GadgetReboot/RS485_GPIO/README.md

# RS485_GPIO
16 Switch Inputs to RS485 Control Outputs
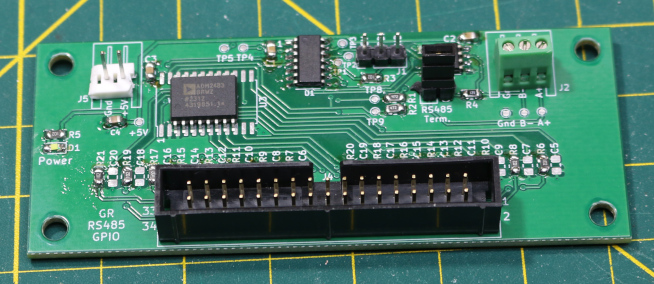
[picture p1: Assembled_PCB.JPG]
PCB
<br><br><BR><BR>
