GadgetReboot/RS485_GPIO/GR_RS485_Switches_Sch.pdf

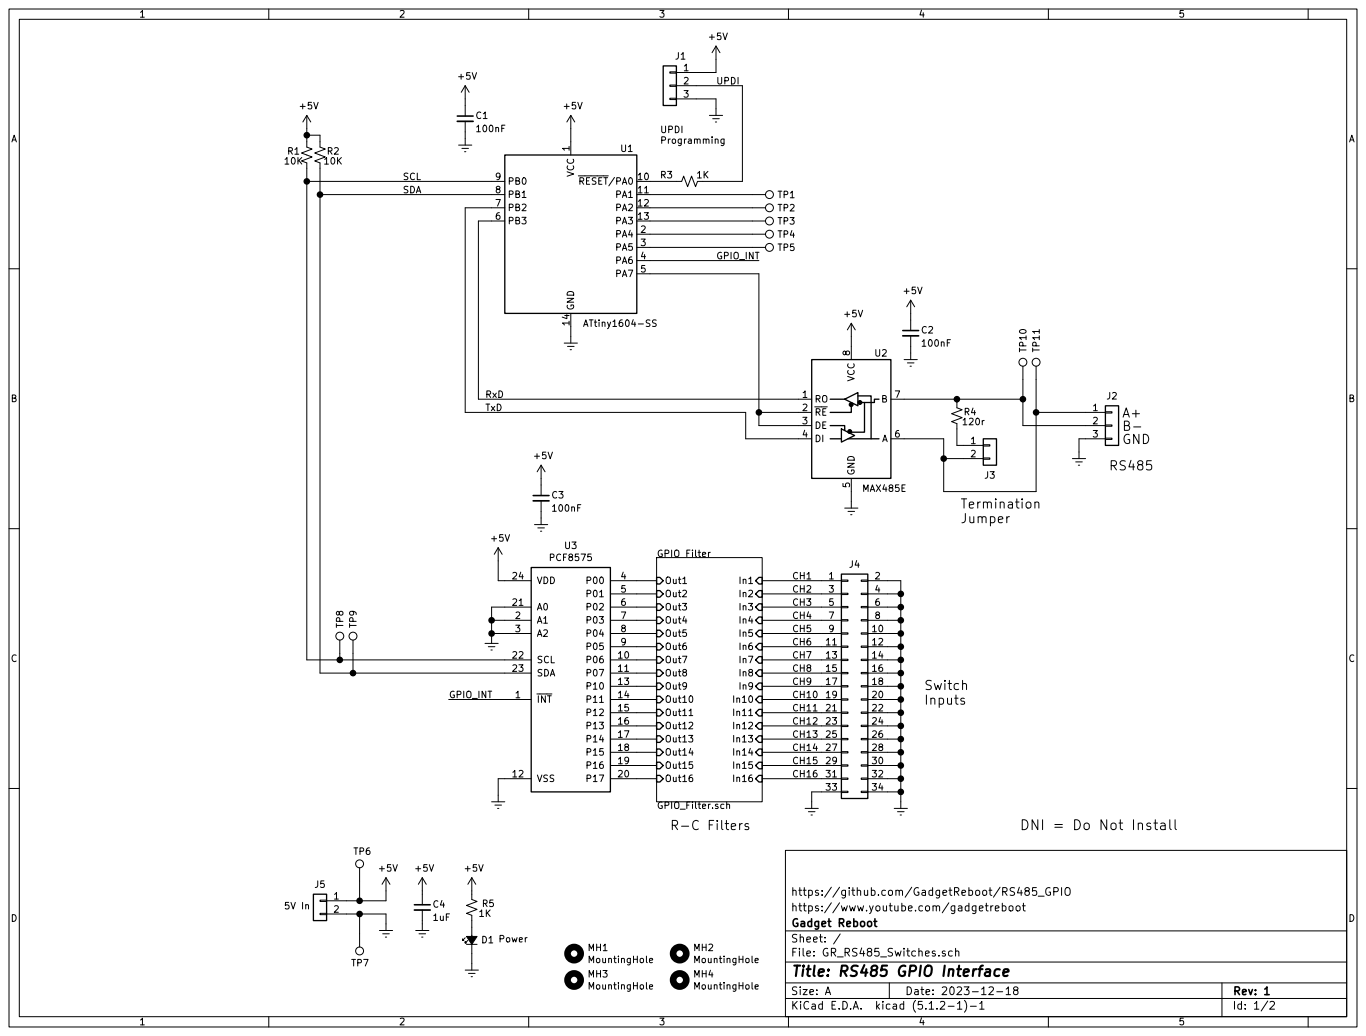
[picture p2: page 1]

15 | 16
17 | 18

21 | 22
23 | 24
25 | 26
27 | 28

https://github.com/GadgetReboot/RS485_GPIO
https://www.youtube.com/gadgetreboot
File: GR_RS485_Switches.sch Sheet: / Gadget Reboot

Id: 1/2 Title: RS485 GPIO Interface

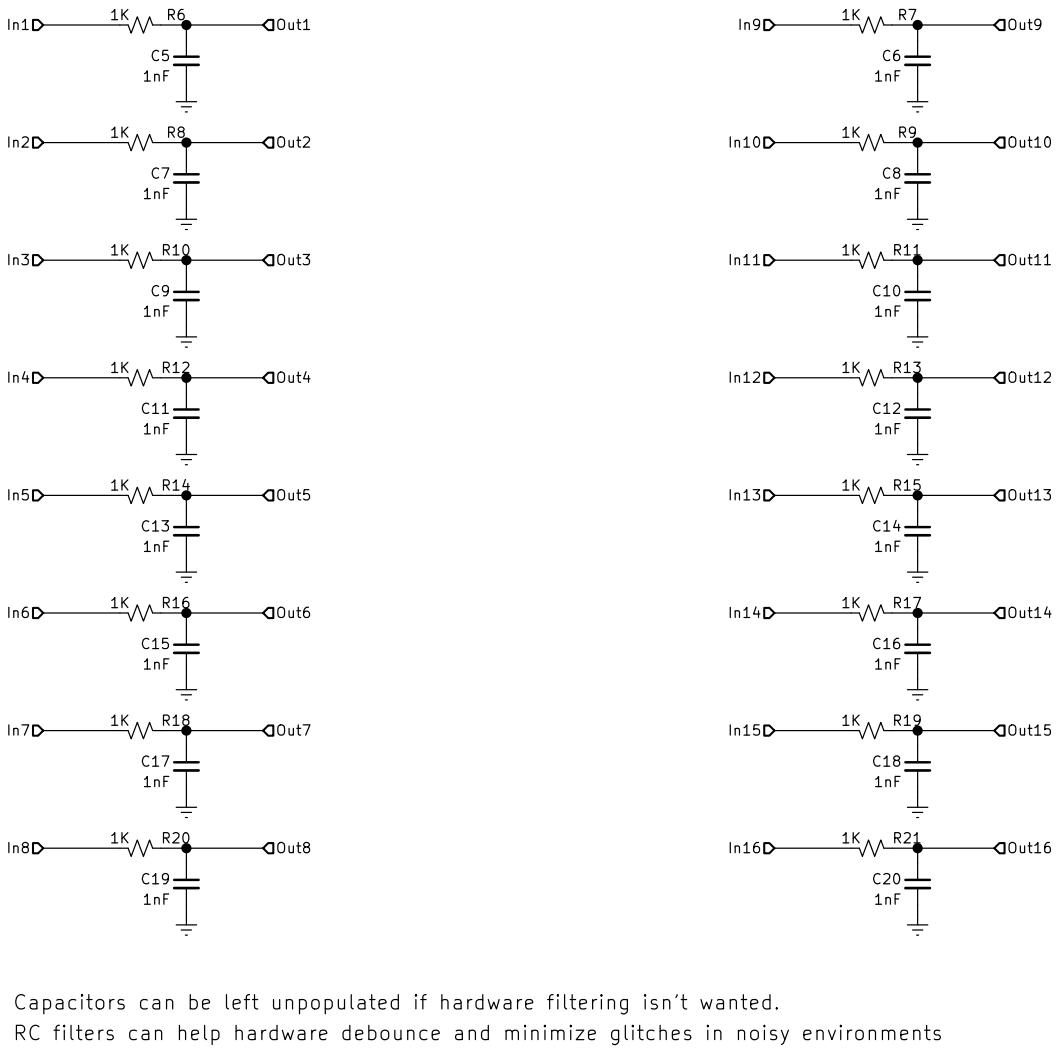
[picture p3: page 2]

Out9 Out10 Out11 Out12 Out13 Out14 Out15 Out16 Capacitors can be left unpopulated if hardware filtering isnt wanted.

RC filters can help hardware debounce and minimize glitches in noisy environments

File: GPIO_Filter.sch Sheet: /GPIO Filter/
Id: 2/2 Title:
