GadgetReboot/RS485_GPIO/KiCad/GR_RS485_Switches.kicad_pcb

## KiCad design KiCad/GR_RS485_Switches.kicad_pcb (2023-12-19)

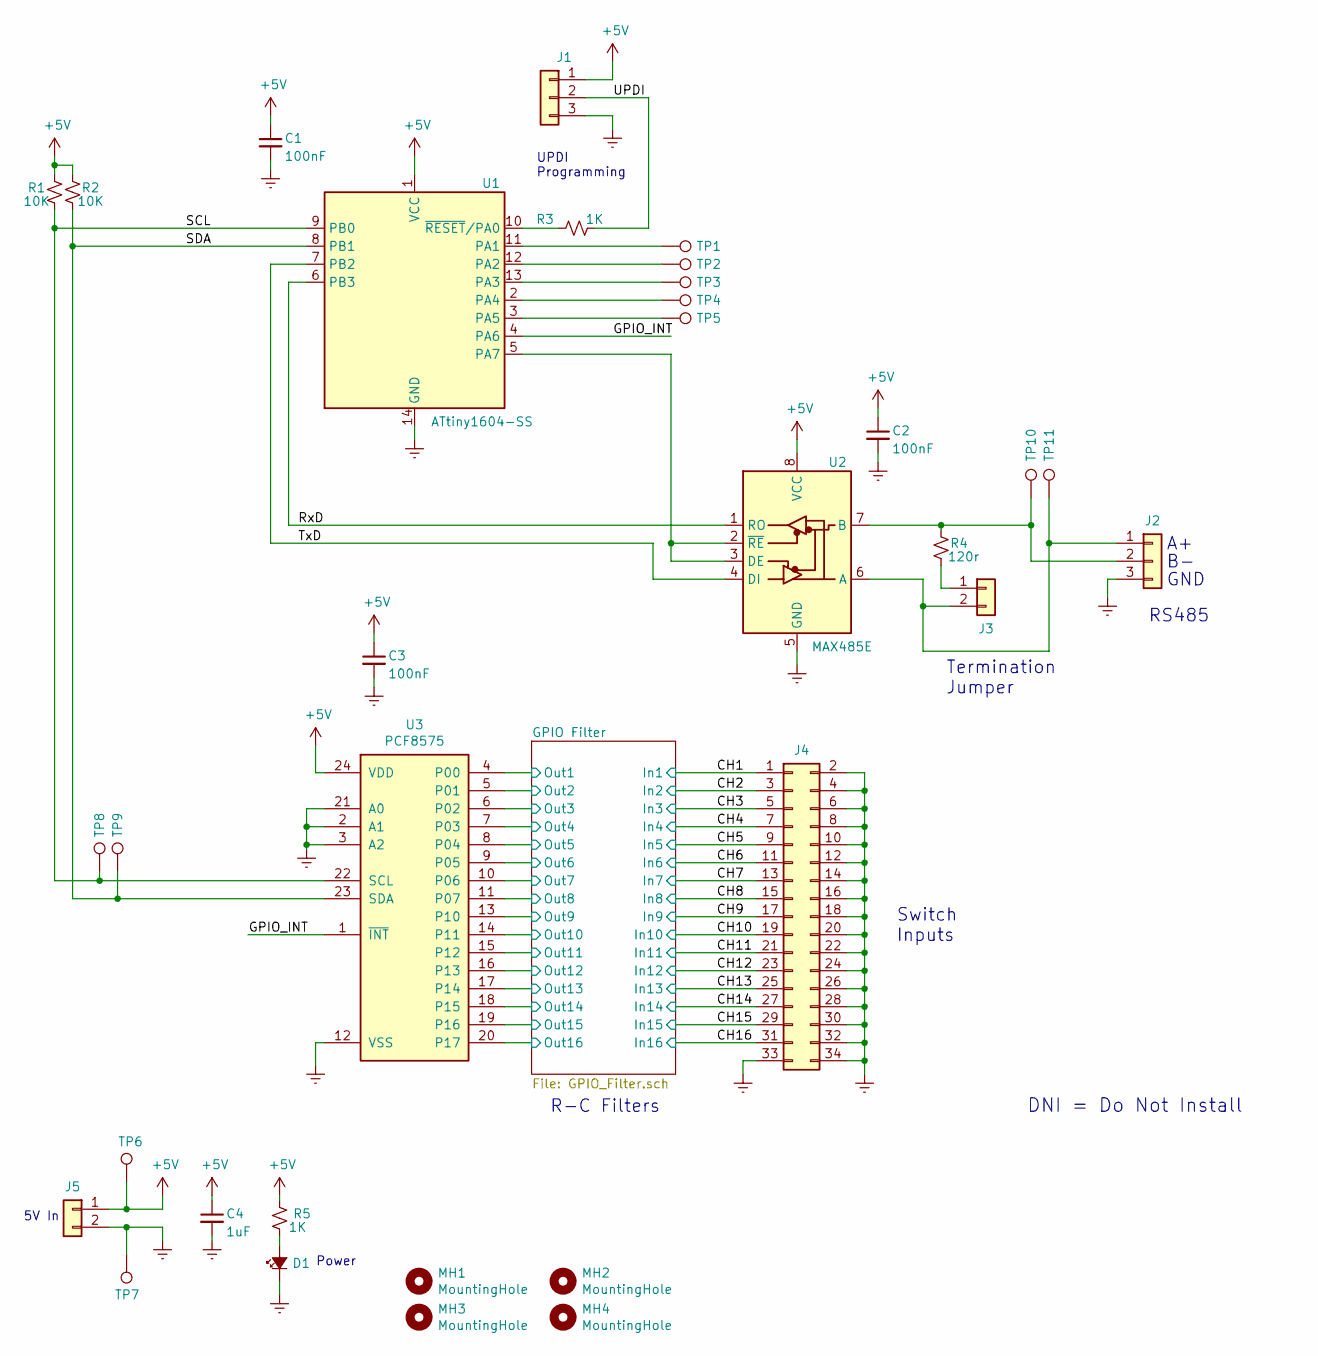
[picture p4: schematic GR_RS485_Switches.sch, RS485 GPIO Interface]

Parts:
C1, C2, C3: 100nF; C_0805_2012Metric_Pad1.15x1.40mm_HandSolder
C4: 1uF; C_0805_2012Metric_Pad1.15x1.40mm_HandSolder
D1: LED_Small_ALT; LED_0805_2012Metric_Pad1.15x1.40mm_HandSolder
J1: Conn_01x03; PinHeader_1x03_P2.54mm_Vertical
J2: Conn_01x03; JST_XH_S3B-XH-A-1_1x03_P2.50mm_Horizontal
J3: Conn_01x02; PinHeader_1x02_P2.54mm_Vertical
J4: Conn_02x17_Odd_Even; IDC-Header_2x17_P2.54mm_Vertical
J5: Conn_01x02; JST_XH_S2B-XH-A-1_1x02_P2.50mm_Horizontal
MH1, MH2, MH3, MH4: MountingHole; MountingHole_3.7mm
R1, R2: 10K; R_0805_2012Metric_Pad1.15x1.40mm_HandSolder
R3, R5: 1K; R_0805_2012Metric_Pad1.15x1.40mm_HandSolder
R4: 120r; R_0805_2012Metric_Pad1.15x1.40mm_HandSolder
TP1, TP2, TP3, TP4, TP5, TP6, TP7, TP8, TP9, TP10, TP11: TestPoint; TestPoint_Pad_D1.0mm
U1: ATtiny1604-SS; SOIC-14_3.9x8.7mm_P1.27mm
U2: MAX485E; SOIC-8_3.9x4.9mm_P1.27mm
U3: PCF8575; SOIC-24W_7.5x15.4mm_P1.27mm

Connections:
+5V: C1.1, C2.1, C3.1, C4.1, J1.1, J5.1, R1.2, R2.2, R5.2, TP6.1, U1.1 (VCC), U2.8 (VCC), U3.24 (VDD)
/CH1: J4.1; also elsewhere on the board
/CH2: J4.3; also elsewhere on the board
/CH3: J4.5; also elsewhere on the board
/CH4: J4.7; also elsewhere on the board
/CH5: J4.9; also elsewhere on the board
/CH6: J4.11; also elsewhere on the board
/CH7: J4.13; also elsewhere on the board
/CH8: J4.15; also elsewhere on the board
/CH9: J4.17; also elsewhere on the board
/CH10: J4.19; also elsewhere on the board
/CH11: J4.21; also elsewhere on the board
/CH12: J4.23; also elsewhere on the board
/CH13: J4.25; also elsewhere on the board
/CH14: J4.27; also elsewhere on the board
/CH15: J4.29; also elsewhere on the board
/CH16: J4.31; also elsewhere on the board
/GPIO Filter/Out1: U3.4 (P00); also elsewhere on the board
/GPIO Filter/Out2: U3.5 (P01); also elsewhere on the board
/GPIO Filter/Out3: U3.6 (P02); also elsewhere on the board
/GPIO Filter/Out4: U3.7 (P03); also elsewhere on the board
/GPIO Filter/Out5: U3.8 (P04); also elsewhere on the board
/GPIO Filter/Out6: U3.9 (P05); also elsewhere on the board
/GPIO Filter/Out7: U3.10 (P06); also elsewhere on the board
/GPIO Filter/Out8: U3.11 (P07); also elsewhere on the board
/GPIO Filter/Out9: U3.13 (P10); also elsewhere on the board
/GPIO Filter/Out10: U3.14 (P11); also elsewhere on the board
/GPIO Filter/Out11: U3.15 (P12); also elsewhere on the board
/GPIO Filter/Out12: U3.16 (P13); also elsewhere on the board
/GPIO Filter/Out13: U3.17 (P14); also elsewhere on the board
/GPIO Filter/Out14: U3.18 (P15); also elsewhere on the board
/GPIO Filter/Out15: U3.19 (P16); also elsewhere on the board
/GPIO Filter/Out16: U3.20 (P17); also elsewhere on the board
/GPIO_INT: U1.4 (PA6), U3.1 (~INT)
/RxD: U1.6 (PB3), U2.1 (RO)
/SCL: R1.1, TP8.1, U1.9 (PB0), U3.22 (SCL)
/SDA: R2.1, TP9.1, U1.8 (PB1), U3.23 (SDA)
/TxD: U1.7 (PB2), U2.4 (DI)
/UPDI: J1.2, R3.1
GNDREF: C1.2, C2.2, C3.2, C4.2, D1.1 (K), J1.3, J2.3, J4.2, J4.4, J4.6, J4.8, J4.10, J4.12, J4.14, J4.16, J4.18, J4.20, J4.22, J4.24, J4.26, J4.28, J4.30, J4.32, J4.33, J4.34, J5.2, TP7.1, U1.14 (GND), U2.5 (GND), U3.2 (A1), U3.3 (A2), U3.12 (VSS), U3.21 (A0); also elsewhere on the board
unnamed: D1.2 (A), R5.1
unnamed: J2.1, J3.2, TP11.1, U2.6 (A)
unnamed: J2.2, R4.2, TP10.1, U2.7 (B)
unnamed: J3.1, R4.1
unnamed: R3.2, U1.10 (~RESET~/PA0)
unnamed: TP1.1, U1.11 (PA1)
unnamed: TP2.1, U1.12 (PA2)
unnamed: TP3.1, U1.13 (PA3)
unnamed: TP4.1, U1.2 (PA4)
unnamed: TP5.1, U1.3 (PA5)
unnamed: U1.5 (PA7), U2.2 (~RE), U2.3 (DE)

Notes on the sheet:
5V In
UPDI Programming
DNI = Do Not Install
Switch Inputs
R-C Filters
GND
RS485
Termination Jumper
Power

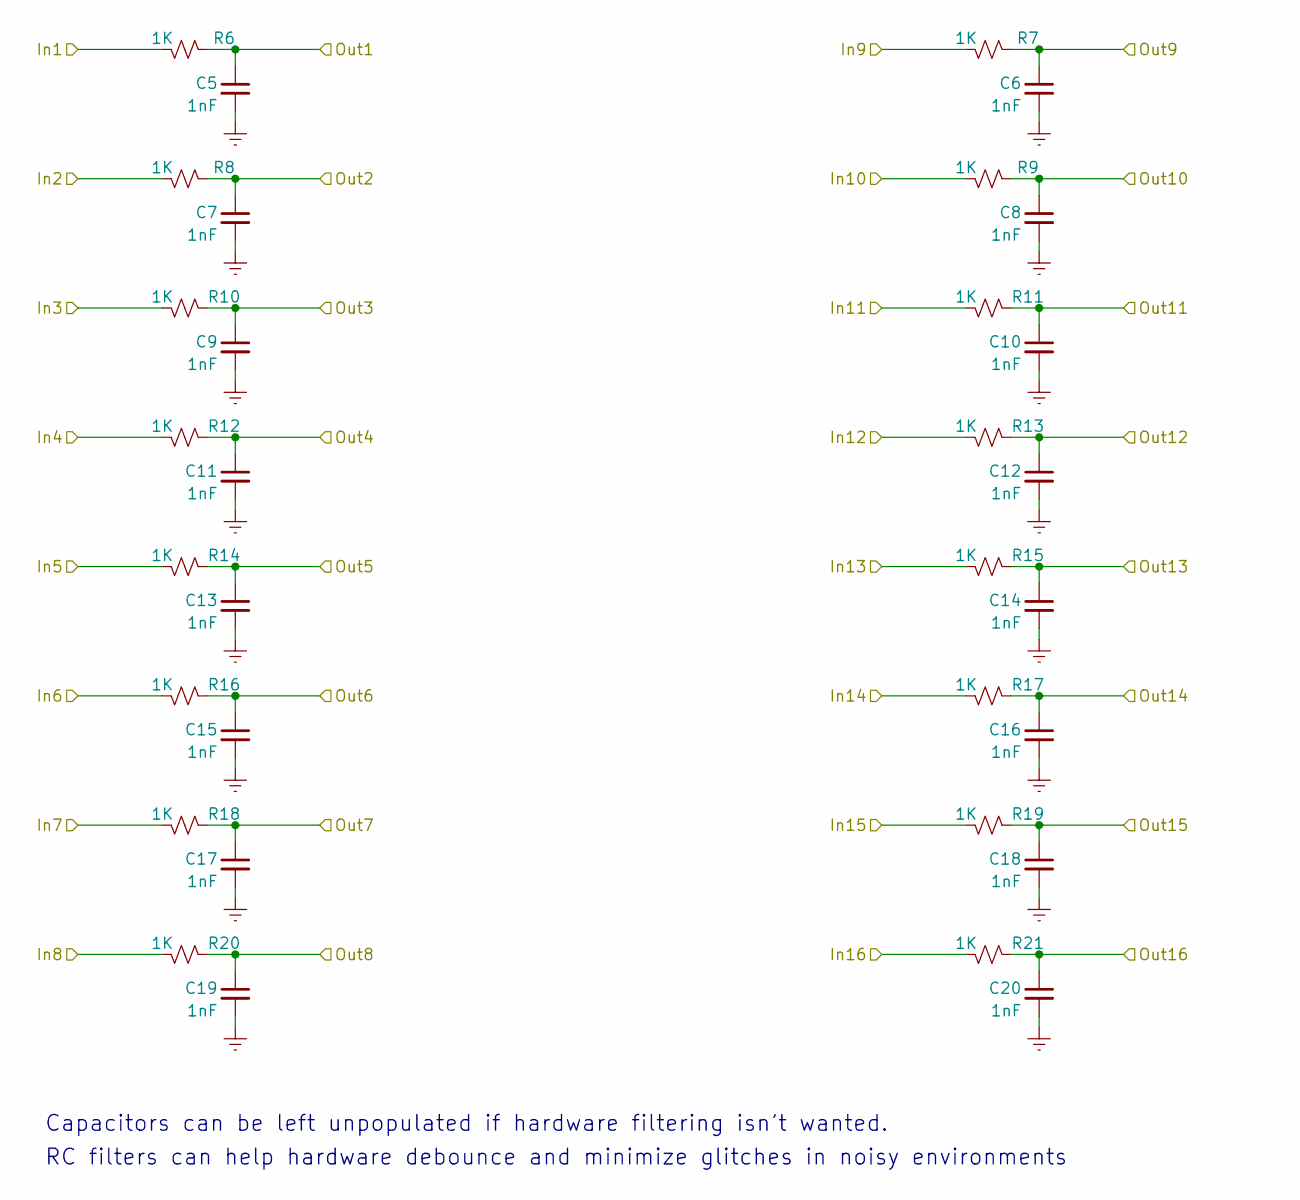
[picture p5: schematic GPIO_Filter.sch]

Parts:
C5, C6, C7, C8, C9, C10, C11, C12, C13, C14, C15, C16, C17, C18, C19, C20: 1nF; C_0805_2012Metric_Pad1.15x1.40mm_HandSolder
R6, R7, R8, R9, R10, R11, R12, R13, R14, R15, R16, R17, R18, R19, R20, R21: 1K; R_0805_2012Metric_Pad1.15x1.40mm_HandSolder

Connections:
/CH1: R6.1; also elsewhere on the board
/CH2: R8.1; also elsewhere on the board
/CH3: R10.1; also elsewhere on the board
/CH4: R12.1; also elsewhere on the board
/CH5: R14.1; also elsewhere on the board
/CH6: R16.1; also elsewhere on the board
/CH7: R18.1; also elsewhere on the board
/CH8: R20.1; also elsewhere on the board
/CH9: R7.1; also elsewhere on the board
/CH10: R9.1; also elsewhere on the board
/CH11: R11.1; also elsewhere on the board
/CH12: R13.1; also elsewhere on the board
/CH13: R15.1; also elsewhere on the board
/CH14: R17.1; also elsewhere on the board
/CH15: R19.1; also elsewhere on the board
/CH16: R21.1; also elsewhere on the board
/GPIO Filter/Out1: C5.1, R6.2; also elsewhere on the board
/GPIO Filter/Out2: C7.1, R8.2; also elsewhere on the board
/GPIO Filter/Out3: C9.1, R10.2; also elsewhere on the board
/GPIO Filter/Out4: C11.1, R12.2; also elsewhere on the board
/GPIO Filter/Out5: C13.1, R14.2; also elsewhere on the board
/GPIO Filter/Out6: C15.1, R16.2; also elsewhere on the board
/GPIO Filter/Out7: C17.1, R18.2; also elsewhere on the board
/GPIO Filter/Out8: C19.1, R20.2; also elsewhere on the board
/GPIO Filter/Out9: C6.1, R7.2; also elsewhere on the board
/GPIO Filter/Out10: C8.1, R9.2; also elsewhere on the board
/GPIO Filter/Out11: C10.1, R11.2; also elsewhere on the board
/GPIO Filter/Out12: C12.1, R13.2; also elsewhere on the board
/GPIO Filter/Out13: C14.1, R15.2; also elsewhere on the board
/GPIO Filter/Out14: C16.1, R17.2; also elsewhere on the board
/GPIO Filter/Out15: C18.1, R19.2; also elsewhere on the board
/GPIO Filter/Out16: C20.1, R21.2; also elsewhere on the board
GNDREF: C5.2, C6.2, C7.2, C8.2, C9.2, C10.2, C11.2, C12.2, C13.2, C14.2, C15.2, C16.2, C17.2, C18.2, C19.2, C20.2; also elsewhere on the board

Notes on the sheet:
Capacitors can be left unpopulated if hardware filtering isn’t wanted.
RC filters can help hardware debounce and minimize glitches in noisy environments

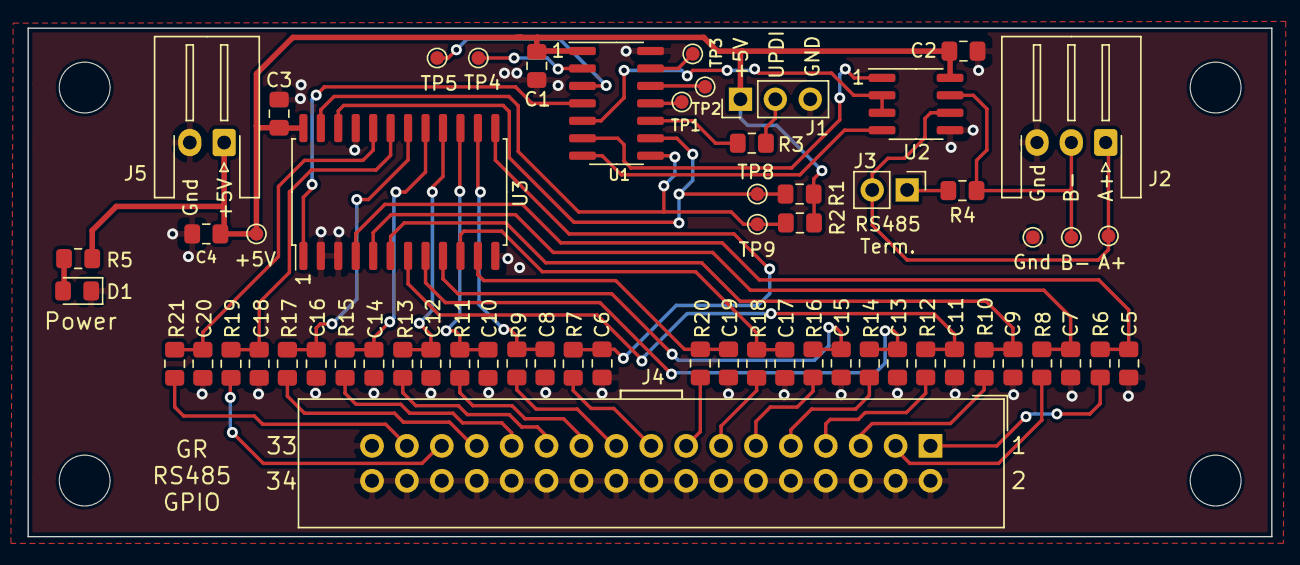
[picture p6: board GR_RS485_Switches.kicad_pcb from above]

Board: 2 copper layers, 90.5 x 37.0 mm, 65 parts (0 on the bottom side), 51 nets.
